minhkhac011203dx-debug/BUCK-DC-DC/(list of files, drawings)

Other design files:
PCB_Buck_power.PrjPcb
PCB_layout.PcbDoc
schematic.SchDoc
